scemtan/Energy_Saver_For_Hotel/README.md

# Energy_Saver_for_Hotel
Otel oda elektrik kontrol sistemi
