scemtan/Energy_Saver_For_Hotel/PCB/PCB-MAIN_ETHERNET/Hotel_Energy_Saver_Spare_List.pdf

Quantity | Stock Code | Part Description | Birim Fiyat | Toplam Fiyat
4 | CL21C220JCANNNC | MLCC (2012) 0805 22pF 100VDC ±5% C0G (NP0) | 0,0676 | 0,2704
2 | T491X686K025AT | CAP.TANTAL 68uF 25V 10% 7343 | 5,919 | 11,838
6 | CL21C101JBANNNC | MLCC (2012) 0805 100pF 50VDC ±5% C0G (NP0) | 0,07617 | 0,45702
2 | CL21C220JCANNNC | MLCC (2012) 0805 22pF 100VDC ±5% C0G (NP0) | 0,0676 | 0,1352
1 | C323C473J60A605 | CAP.POL.47nF 1600V 15MM 5% TB FARATRONIC | 2,33948 | 2,33948
2 | C323C103J60A605 | CAP.POL.10nF 1600VDC 15MM 5% MKP TB FARATRONIC | 1,0634 | 2,1268
2 | T491C106K025AT | CAP.TANTAL 10uF 25V 10% C CASE (6032) SMD | 1,57606 | 3,15212
7 | CL21B103KAANNNC | MLCC (2012) 0805 10nF 25VDC ±10% X7R | 0,06958 | 0,48706
2 | CL21B104KACNNND | MLCC (2012) 0805 100nF 25VDC ±10% X7R | 0,07926 | 0,15852
2 | T491B684K035AT | CAP.TANTAL 680uF 35V 10% B CASE (3528) | 0,92321 | 1,84642
2 | DR2R7305R | CAP.SUPER 3F 2.7V 8X20MM RADIAL THT | 5,31701 | 10,63402
11 | 0805S8F1002T5E | RES.(2012) 0805 10K Ohms 1% 1/8W-S 100PPM | 0,02095 | 0,23045
1 | 0805S8F1004T5E | RES.(2012) 0805 1M Ohms 1% 1/8W-S 100PPM | 0,02095 | 0,02095
10 | 0805S8F4700T5E | RES.(2012) 0805 470 Ohms 1% 1/8W-S 100PPM | 0,02095 | 0,2095
7 | 0805S8F1001T5E | RES.(2012) 0805 1K Ohms 1% 1/8W-S 100PPM | 0,02095 | 0,14665
1 | TC0650F3600T5G | RES.(3216) 1206 360 Ohms 1% 1/8W 50PPM | 0,13211 | 0,13211
1 | TC0650F4700T5G | RES.(3216) 1206 470 Ohms 1% 1/8W 50PPM | 0,13211 | 0,13211
1 | TC0650F390JT5G | RES.(3216) 1206 39 Ohms 1% 1/8W 50PPM | 0,13211 | 0,13211
2 | 0805S8F5600T5E | RES.(2012) 0805 560 Ohms 1% 1/8W-S 100PPM | 0,02095 | 0,0419
1 | 0805S8F2001T5E | RES.(2012) 0805 2K Ohms 1% 1/8W-S 100PPM | 0,02095 | 0,02095
1 | 0805S8F0000T5E | RES.(2012) 0805 0 Ohms 1% 1/8W-S 800PPM | 0,01264 | 0,01264
4 | 0805S8F499JT5E | RES.(2012) 0805 49.9 Ohms 1% 1/8W-S 200PPM | 0,02095 | 0,0838
1 | 0805S8F100JT5E | RES.(2012) 0805 10 Ohms 1% 1/8W-S 400PPM | 0,02095 | 0,02095
1 | 0402WGJ0222TCE | RES.(1005) 0402 2.2K Ohms 5% 1/16W 100PPM | 0,00446 | 0,00446
1 | 0402WGJ0103TCE | RES.(1005) 0402 10K Ohms 5% 1/16W 100PPM | 0,00446 | 0,00446
2 | 0402WGJ0221TCE | RES.(1005) 0402 220 Ohms 5% 1/16W 100PPM | 0,00446 | 0,00892
1 | 0402WGJ0000TCE | RES.(1005) 0402 0 Ohms 5% 1/16W 800PPM | 0,00446 | 0,00446
1 | 0805S8J0000T5E | RES.(2012) 0805 0 Ohms 5% 1/8W-S 800PPM | 0,00446 | 0,00446
1 | ATMEGA328PB-AU | IC-328PB MCU 8BIT 32KB FLASH 32TQFP | 16,94353 | 16,94353
1 | L7805CV-DG | IC-7805 V.REG.+5V 1.5A TO220 DOUBLE GAUGE ST | 1,20548 | 1,20548
1 | LM1117GS-3.3-HTC | IC-1117 3V3 LDO SOT223 SMD | 1,61341 | 1,61341
1 | MOC3021-ISO | IC-3021 DIP6 ISOCOM | 1,68372 | 1,68372
1 | BT138-600E-70127 | TRIAC DIS.12A 600V NONISOLATED SENSITIVITY TO220 | 2,74639 | 2,74639
2 | SN74LVC1G14DBVRE4 | IC-74LVC1G14 SGL SCHMT-TRIG INVERTER SOT23-5 | 0,62273 | 1,24546
1 | DI206S_R2_00001 | DIODE BRIDGE 2A 600V 1PH 4-SDIP SMT GLASS PASSIVAT | 1,77322 | 1,77322
1 | L-KLS7-TS3603B-5.0-250-T | SWITCH TACT 3.50x6.00 5.00mm 250gF SMT V/T | 0,36594 | 0,36594
1 | ENC28J60-I/SO | IC-28J60 SOIC-28 MICROCHIP | 26,76226 | 26,76226
1 | CAT24C256WI-GT3 | IC-24C256 EEPROM CMOS SMD SO8 TR ON | 2,09933 | 2,09933
4 | HL-PST-1608S9AC | LED SMD 0603 RED WATER CLEAR 50-70mcd 130C | 0,19925 | 0,797
4 | BZX84C3V3,215 | DIODE ZENER 410mW 3.3V ±5% SOT23 SMT | 0,13239 | 0,52956
4 | HL-PST-1608U51GC | LED SMD 0603 GREEN WATER CLEAR 600-800mcd 130C | 0,12025 | 0,481
4 | HL-PST-1608H203BC | LED SMD 0603 BLUE WATER CLEAR 70-100mcd 130C | 0,13109 | 0,52436
1 | MBR0520-HT | DIODE SCHOTTKY 500mA 20V SOD123 HOTTECH | 0,18078 | 0,18078
2 | M7-KT | DIODE STAND. Single 1A 1000V SMT DO214AC (SMA) | 0,06372 | 0,12744
1 | A3-5A-F | THERMAL FUSE 5A 250V 125C | 1,05808 | 1,05808
2 | MOLEX-0901310123 | PIN HEADER 6PIN(2x3) 2.54mm THT V/T | 1,52186 | 3,04372
6 | GT130-5.08-03P-14-05AH | TERM.BLK.5.08MM 3P PCB TYPE GREEN GOLTEN | 1,27608 | 7,65648
1 | HR911105A | MODULAR JACK THT R/A 8P8C (RJ45,Ethernet) GRAY | 7,38229 | 7,38229
1 | DLW21HN900SQ2L | CHOKE COMMON MODE 90R 330MA LN SMD | 0,54765 | 0,54765
1 | AS49S-16M-FC160F3 | CRYSTAL 16MHZ HC49S 16pF 20ppm SHORT BULK ANSEN | 0,85072 | 0,85072
1 | AS-25.000-18-F-H25 | CRYSTAL 25MHZ HC49ST 18PF SHORT BULK RALTRON | 1,77234 | 1,77234
1 | L-KLS1-TDC-001-2.0-T | CONNECTOR JACK DC POWER 2MM SMD | 1,33434 | 1,33434
1 | L-KLS7-MSK-12C03 | SWITCH SLIDE 1P2T SMT R/A | 1,52996 | 1,52996
1 | H11L1M | IC-11L1M OPTOISO 4.17KV OPEN COLLECTOR 6DIP | 3,63634 | 3,63634
1 | 1N4148-T4-HT | DIODE FAST SWITCHING Single 150mA 75V SMT SOD323 | 0,0543 | 0,0543
1 | | 12V 2A Adaptör | 15 | 15
1 | PCB | 1.65$ | 12,25 | 12,25
1 | ATTINY85-20SUR | ATTINY85-20SUR | 14,62265 | 14,62265
| 0
| 0
Toplam | 164,47367
KDV | 18%
Genel Toplam | 194,0789306
