scemtan/Energy_Saver_For_Hotel/PCB/PCB-MAIN_ETHERNET/Hotel_Energy_Saver_Bottom.pdf

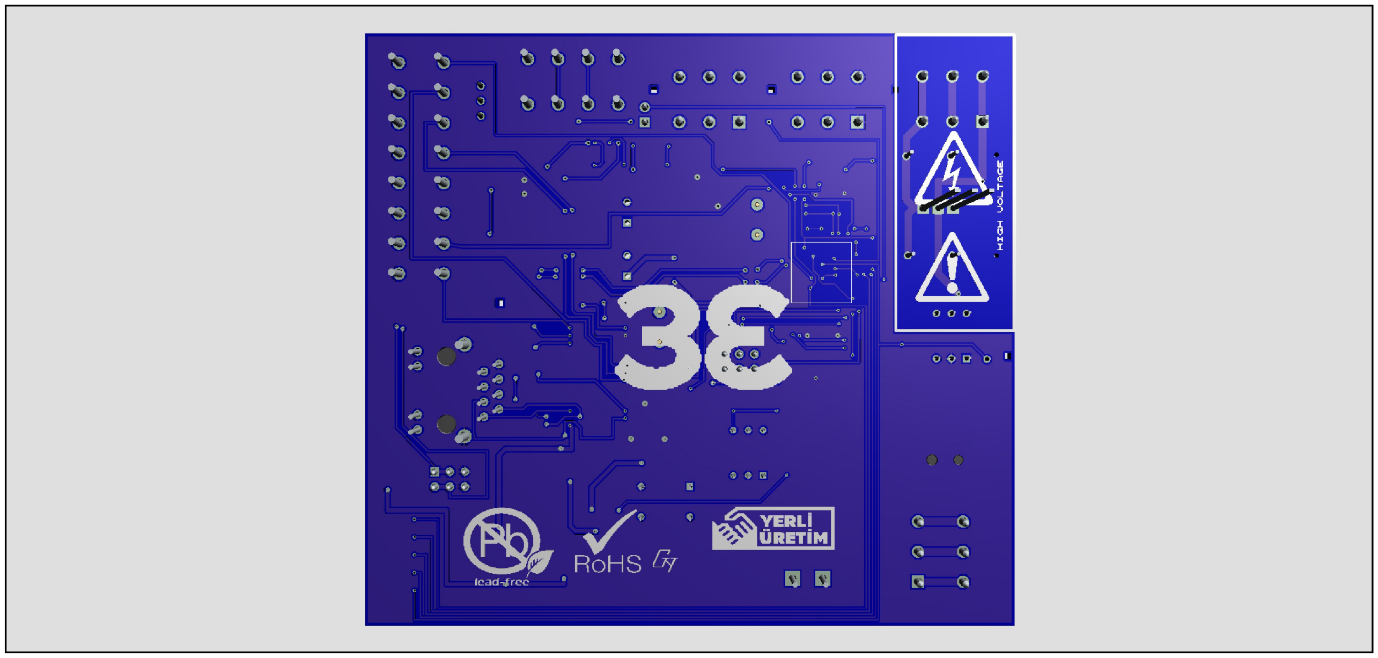
[picture p3: figure]
