scemtan/Energy_Saver_For_Hotel/PCB-MAIN_ETHERNET_BOM_LIST.pdf

sıra | parça no | stok kod | ürün açıklaması | adet
1 | C1-C2,C14-C15 | CL21C220JCANNNC | MLCC (2012) 0805 22pF 100VDC ±5% C0G (NP0) | 4
2 | C3-C4 | T491X686K025AT | CAP.TANTAL 68uF 25V 10% 7343 | 2
3 | C5-C10 | CL21C101JBANNNC | MLCC (2012) 0805 100pF 50VDC ±5% C0G (NP0) | 6
4 | C12 | C323C473J60A605 | CAP.POL.47nF 1600V 15MM 5% TB FARATRONIC | 1
5 | C13 | C323C103J60A605 | CAP.POL.10nF 1600VDC 15MM 5% MKP TB FARATRONIC | 1
6 | C16,C22 | T491C106K025AT | CAP.TANTAL 10uF 25V 10% C CASE (6032) SMD | 2
7 | C17-C21,C23-C24 | CL21B103KCANNNC | MLCC (2012) 0805 10nF 100VDC ±10% X7R | 4
8 | C26,C29,C11,C25 | CL21B104KBCNNND | MLCC (2012) 0805 100nF 50VDC ±10% X7R | 4
9 | C27-C28 | T491B684K035AT | CAP.TANTAL 680uF 35V 10% B CASE (3528) | 2
10 | C30-C31 | DR2R7305R | CAP.SUPER 3F 2.7V 8X20MM RADIAL THT | 2
11 | R1-R4,R12,R17-R18,R36-R37,R40 | 0805S8F1002T5E | RES.(2012) 0805 10K Ohms 1% 1/8W-S 100PPM | 10
12 | R5 | 0805S8J0105T5E | RES.(2012) 0805 1M Ohms 5% 1/8W-S 100PPM | 1
13 | R6,R13-R14,R29-R35,R48 | 0805S8J0471T5E | RES.(2012) 0805 470 Ohms 5% 1/8W-S 100PPM | 11
14 | R7-R8,R15-R16,R27-R28,R38 | 0805S8F1001T5E | RES.(2012) 0805 1K Ohms 1% 1/8W-S 100PPM | 7
15 | R9 | 1206S4F3600T5E | RES.(3216) 1206 360 Ohms 1% 1/4W-S 100PPM | 1
16 | R10 | 1206S4J0471T5E | RES.(3216) 1206 470 Ohms 5% 1/4W-S 100PPM | 1
17 | R11 | 1206S4J0390T5E | RES.(3216) 1206 39 Ohms 5% 1/4W-S 200PPM | 1
18 | R19-R20 | 0805S8F5600T5E | RES.(2012) 0805 560 Ohms 1% 1/8W-S 100PPM | 2
19 | R21 | 0805S8F2001T5E | RES.(2012) 0805 2K Ohms 1% 1/8W-S 100PPM | 1
20 | R22,R41-R42 | 0805S8J0000T5E | RES.(2012) 0805 0 Ohms 5% 1/8W-S 800PPM | 3
21 | R23-R26 | 0805S8F499JT5E | RES.(2012) 0805 49.9 Ohms 1% 1/8W-S 200PPM | 4
22 | R39 | 0805S8F100JT5E | RES.(2012) 0805 10 Ohms 1% 1/8W-S 400PPM | 1
23 | R45 | 0402WGJ0222TCE | RES.(1005) 0402 2.2K Ohms 5% 1/16W 100PPM | 1
24 | R47-R49 | 0402WGJ0103TCE | RES.(1005) 0402 10K Ohms 5% 1/16W 100PPM | 2
25 | R46 | 0402WGJ0221TCE | RES.(1005) 0402 220 Ohms 5% 1/16W 100PPM | 1
26 | R43-R44-SDA-SCL | 0402WGJ0000TCE | RES.(1005) 0402 0 Ohms 5% 1/16W 800PPM | 4
27 | U1 | ATMEGA328P-AU | IC-328 MCU 8BIT 32KB FLASH 32TQPF ATMEL | 1
28 | U2 | L7805CV-DG | IC-7805 V.REG.+5V 1.5A TO220 DOUBLE GAUGE ST | 1
29 | U3 | LM1117GS-3.3-HTC | IC-1117 3V3 LDO SOT223 SMD | 1
30 | U4 | MOC3021M-FSC | IC-3021 OPTOISOLATOR 4.17KV TRIAC 6DIP | 1
31 | U5 | BT138-600E-70127 | TRIAC DIS.12A 600V NONISOLATED SENSITIVITY TO220 | 1
32 | U6-U7 | SN74LVC1G14DBVR | IC-74LVC14 BUFFER SCHMIT TRIG SOT23-5 SMD | 2
33 | U8 | DI206S_R2_00001 | DIODE BRIDGE 2A 600V 1PH 4-SDIP SMT GLASS PASSIVAT | 1
34 | U12-U13 | L-KLS7-TS3603B-5.0-250-T | SWITCH TACT 3.50x6.00 5.00mm 250gF SMT V/T | 1
35 | U10 | ENC28J60-I/SO | IC-28J60 SOIC-28 MICROCHIP | 1
36 | U11 | CAT24C256WI-GT3 | IC-24C256 EEPROM CMOS SMD SO8 TR ON | 1
37 | U14 | H11L1M | IC-11L1M OPTOISO 4.17KV OPEN COLLECTOR 6DIP | 1
38 | U9 | L-KLS7-MSK-12C03 | SWITCH SLIDE 1P2T SMT R/A | 1
39 | X1 | AS49S-16M-FC160F3 | CRYSTAL 16MHZ HC49S 16pF 20ppm SHORT BULK ANSEN | 1
40 | X2 | AS-25.000-18-F-H25 | CRYSTAL 25MHZ HC49ST 18PF SHORT BULK RALTRON | 1
41 | D1-D2-D8-D13 | HL-PST-1608S9AC | LED SMD 0603 RED WATER CLEAR 50-70mcd 130C | 4
42 | D3-D4,D16-D17 | BZX84C3V3,215 | DIODE ZENER 410mW 3.3V ±5% SOT23 SMT | 4
43 | D5,D9,D12 | HL-PST-1608U51GC | LED SMD 0603 GREEN WATER CLEAR 600-800mcd 130C | 3
44 | D6,D10-D11,D19 | HL-PST-1608H203BC | LED SMD 0603 BLUE WATER CLEAR 70-100mcd 130C | 3
45 | D7 | MBR0520-HT | DIODE SCHOTTKY 500mA 20V SOD123 HOTTECH | 1
46 | D14-D15 | M7-KT | DIODE STAND. Single 1A 1000V SMT DO214AC (SMA) | 2
47 | D18 | 1N4148WS-HT | DIODE FAST SWITCHING Single 150mA 75V SMT SOD323 | 1
48 | F1 | A3-5A-F | THERMAL FUSE 5A 250V 125C | 1
49 | J1-J2 | MOLEX-0901310123 | PIN HEADER 6PIN(2x3) 2.54mm THT V/T | 2
50 | J3-J4,J6-J7 | DG142V-5.08-03P-14-00AH | TERM.BLK.5.08MM 3P PCB SPRING TYPE | 4
51 | J5 | HR911105A | MODULAR JACK THT R/A 8P8C (RJ45,Ethernet) GRAY | 1
52 | J8 | DG142V-5.08-04P-14-00AH | TERM.BLK.5.08MM 4P PCB SPRING TYPE | 1
53 | J9 | DG127S-5.08-08P-14-00AH | TERM.BLK.5.08MM 8P PCB TYPE 0 BOY GREEN GAOSONG | 1
54 | J10 | L-KLS1-207A-1-02-TC-R | PIN HEADER 2PIN(1x2) 2.54mm SMT R/A | 1
55 | J14 | L-KLS1-TDC-001-2.0-T | CONNECTOR JACK DC POWER 2MM SMD | 1
56 | L1 | 10mH | | 1
57 | Q1 | BC817-40,215 | TRANSISTOR DIS.500mA 45V NPN SOT23 GEN. SMT | 1
