scemtan/Energy_Saver_For_Hotel/PCB/PCB-MAIN_FOR_THE_GRANADA/hotel_energy_saver_for_the_granada - CADCAM.PDF

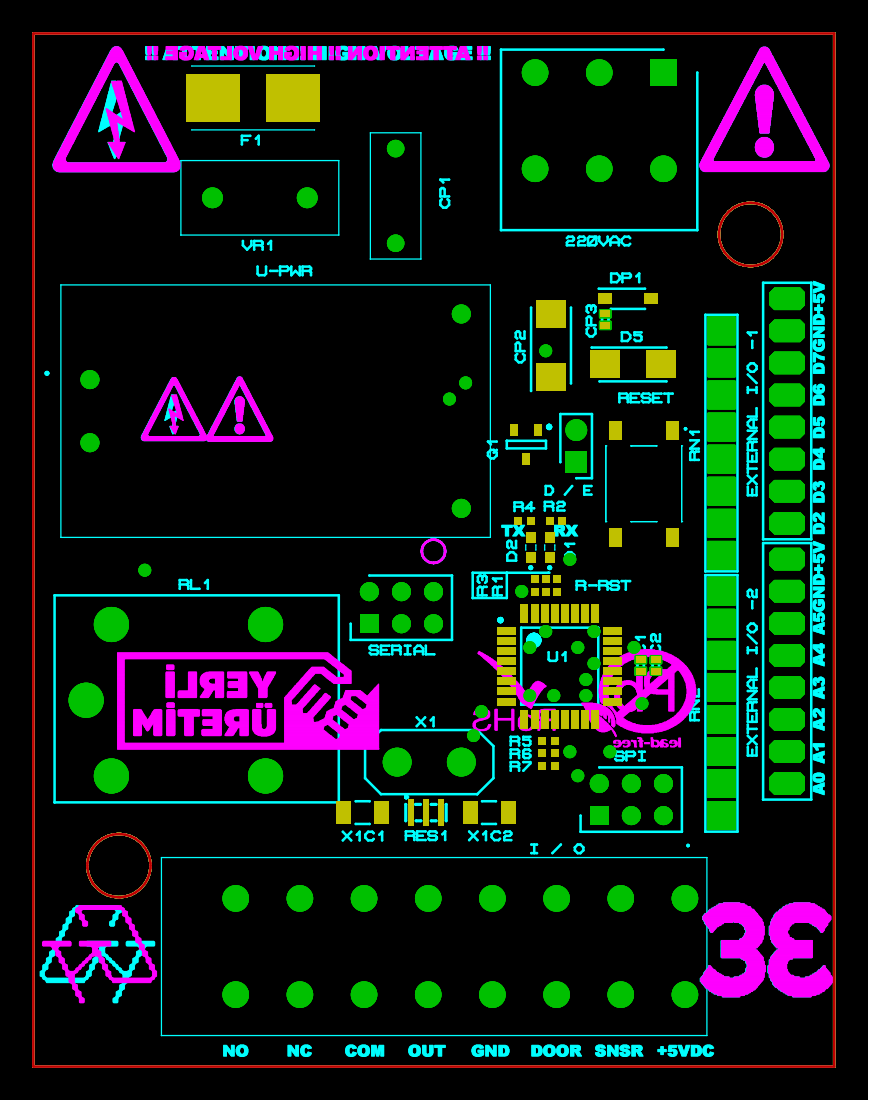
[picture p5: page 1]
