scemtan/Energy_Saver_For_Hotel/PCB/PCB-MAIN_ETHERNET/hotel_energy_saver - CADCAM.PDF

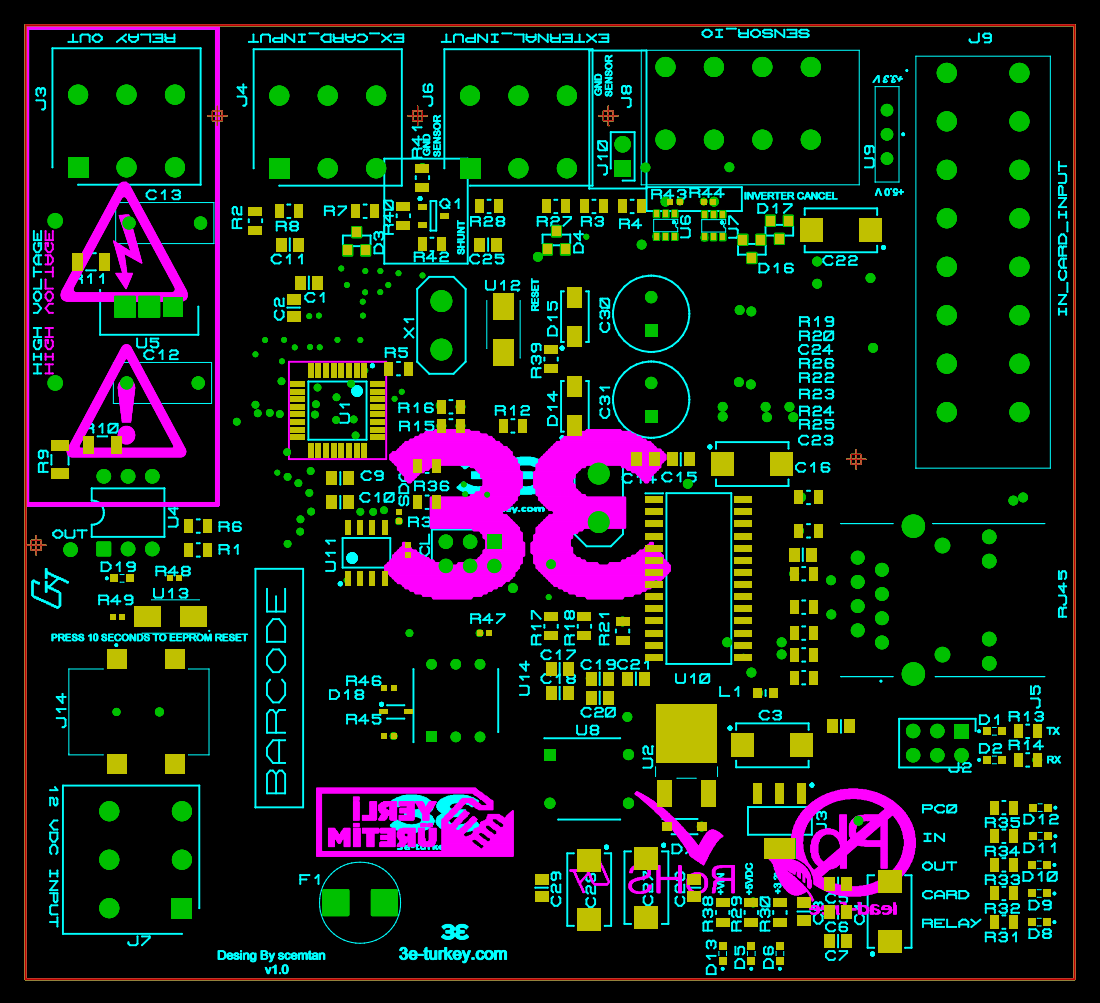
[picture p7: page 1]
