scemtan/Energy_Saver_For_Hotel/PCB/PCB-MAIN_ETHERNET/Hotel_Energy_Saver.pdf

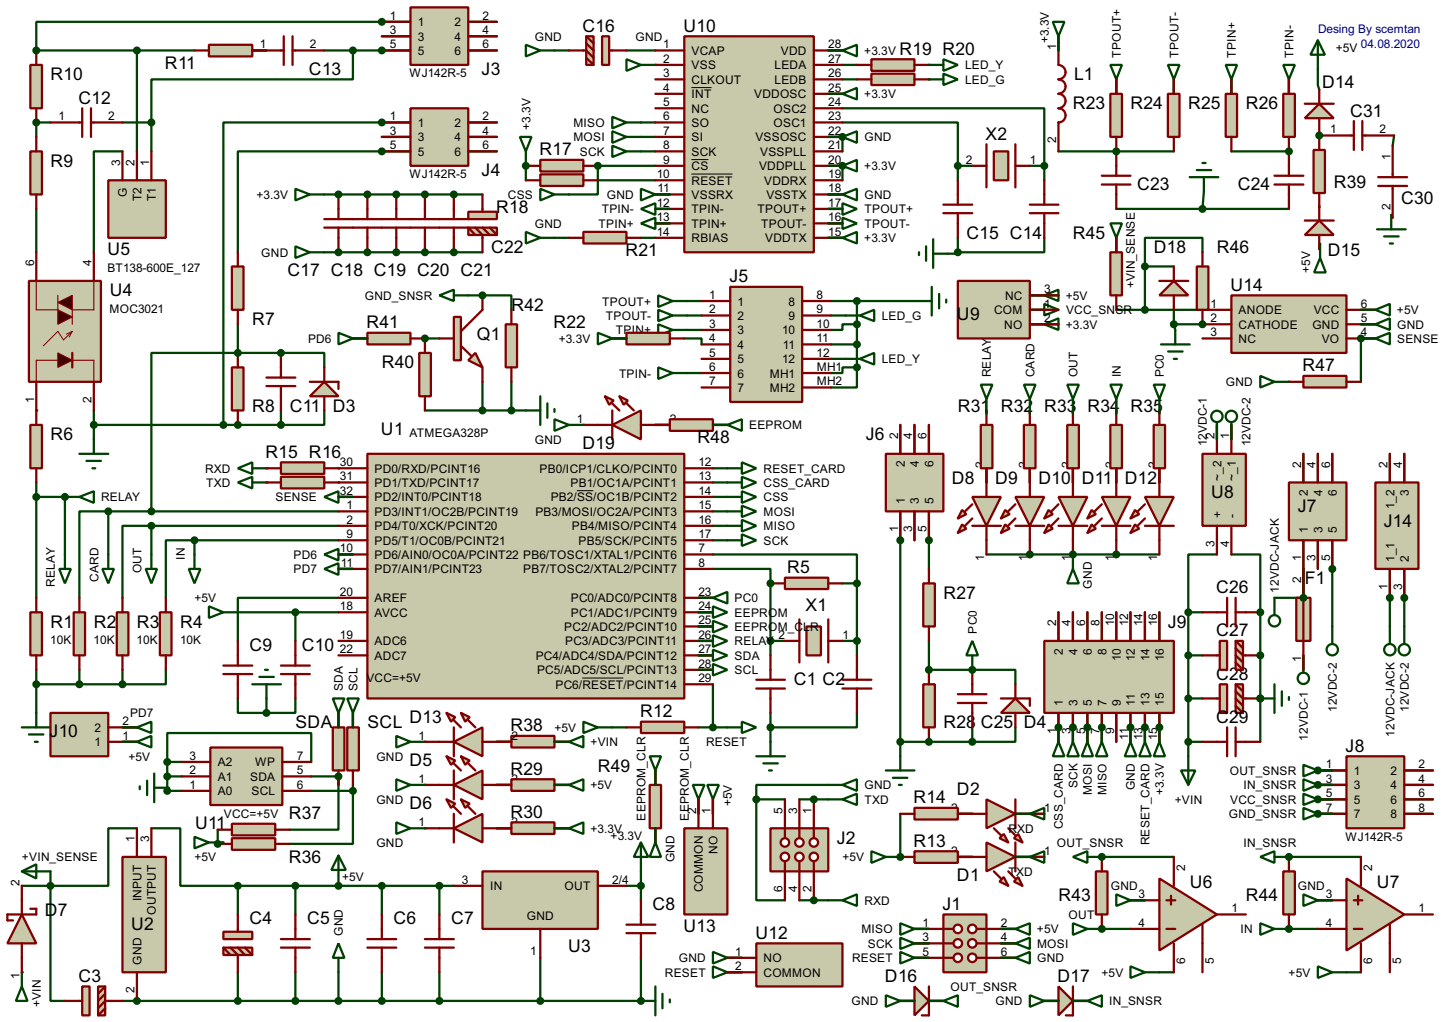
[picture p8: page 1]
