scemtan/Energy_Saver_For_Hotel/(list of files, drawings)

Other design files:
PCB/PCB-MAIN_ETHERNET/hotel_energy_saver.pdsprj
PCB/PCB-MAIN_FOR_THE_GRANADA/hotel_energy_saver_for_the_granada.pdsprj
PCB/PCB-US_SENSOR/Bottom 25X15/ULTRASONIC_SENSOR_DEVRESI.pdsprj
PCB/PCB-US_SENSOR/Top 25X12.5/ULTRASONIC_SENSOR_DEVRESI.pdsprj
