scemtan/Energy_Saver_For_Hotel/Software/otel_enerji_koruma_distan_kartli_sisteme_entegre/otel_enerji_koruma_distan_kartli_sisteme_entegre.ino

#include <avr/wdt.h>
#include <Wire.h>
#include <EEPROM.h>
String s = "0";
unsigned long int xyz = 0;
int address = 143, read_value = 0, eeprom = A1, eeprom_clr = A2, relay = A3, sense = 2,
    EXTERNAL_RFID = 3, OUT = 4, IN = 5, GND = 6, pir_header = 7, count = 0, statePIN = LOW, previous = LOW, say = 0,
    statu, statu_in, statu_out, statu_pir, statu_eeprom, x;
int sclPin = A5, sdaPin = A4;
int gnd_sensor_time = 50; // 1 = 1 msn // açma kapama süresi
int zaman = 300; // 10 = 1 sn // person "0" olunca relay kapanma süresi
int dividing = 10; // zaman'ı bölen sayısı
int t = 500; // iki sensörden geçiş süresi
int t_setup = 2500; // setup bölümünde tanıtım yazı süresi
long time = 0;
long debounce = 200;
boolean state = true;
bool islem = false;
/* Software Communication List ==>
   reset & restart
   eeprom
   clear
   electric
   open
   close
   ++
   --
   sensor
   end
*/
void setup() {
  Serial.begin(115200);
  pinMode(IN, INPUT);
  pinMode(OUT, INPUT);
  pinMode(pir_header, INPUT);
  pinMode(eeprom_clr, INPUT);
  pinMode(eeprom, OUTPUT);
  pinMode(GND, OUTPUT);
  pinMode(relay, OUTPUT);
  digitalWrite(GND, HIGH);
  attachInterrupt(0, electric_sense, RISING);
  Wire.begin();
  Serial.println("3e-turkey.com");
  delay (t_setup);
  Serial.println("OTEL ENERGY SAVER");
  delay (t_setup);
  {
    read_value = EEPROM.read(143);
    if (read_value == 255) {
      count = 0;
    }
    else
    {
      count = read_value;
    }
    Serial.println(count);
  }
}
void toogle_led50() {
  digitalWrite(eeprom, !digitalRead(eeprom));
  delay(50);
}
void electric_sense() {
  Serial.println("ELEKTRİK KESİNTİSİ"); // EEPROM Register
  Serial.println(count);
  EEPROM.write(address, (count & 0xFF));
}
void electric_off(){
  if (digitalRead(sense) == HIGH){
  Serial.println("⚡⚡ ELEKTRIK ⚡⚡ ⚡⚡ KESINTISI 'I2C' ⚡⚡"); //⚡⚡⚡⚡⚡⚡⚡
  }
}
void (*softwareReset)( void ) = 0x0000; // Atmega328P için 0x0000
void software_communication() {
  if (Serial.available() > 0) {
    s = Serial.readString();
  }
  if ((s.indexOf("reset") >= 0) || (s.indexOf("restart") >= 0))  //  if ((s.indexOf("reset") >= 0)
  {
    role_off();
    Serial.println("Software Reset");
    delay(250);
    softwareReset();
  }
  if ((s.indexOf("eeprom") >= 0))
  {
    s = "end";
    read_value = EEPROM.read(143);
    count = read_value;
    Serial.println(count);
  }
  if ((s.indexOf("clear") >= 0))
  {
    Serial.println("EEPROM Clear");
    delay(100);
    eeprom_clear();
    Serial.println("Restart");
    softwareReset();
  }
  if ((s.indexOf("electric") >= 0))
  {
    Serial.println("Electric Data EEPROM Write Test");
    EEPROM.write(address, (142 & 0xFF));
    role_off();
    Serial.println("Restart");
    delay(250);
    softwareReset();
  }
  if ((s.indexOf("open") >= 0))  //  if ((s.indexOf("reset") >= 0) || (s.indexOf("5555") >= 0))
  {
    count = 9999;
    role_on();
  }
  if ((s.indexOf("close") >= 0))  //  if ((s.indexOf("reset") >= 0) || (s.indexOf("5555") >= 0))
  {
    count = 0;
    role_off();
    s = "end";
  }
  if ((s.indexOf("++") >= 0))  //  if ((s.indexOf("reset") >= 0) || (s.indexOf("5555") >= 0))
  {
    count++;
    role_on();
    Serial.println(count);
  }
  if ((s.indexOf("--") >= 0))  //  if ((s.indexOf("reset") >= 0) || (s.indexOf("5555") >= 0))
  {
    count--;
    if (count == 0)
    {
      count = 0;
      role_off();
      s = "end";
      Serial.println("0");
    }
    else if (count <= -1)
    {
      count = 0;
    }
    else
    {
      Serial.println(count);
    }
  }
  if ((s.indexOf("sensor") >= 0))  //  if ((s.indexOf("reset") >= 0) || (s.indexOf("5555") >= 0))
  {
    if (digitalRead(IN) == HIGH) {
      count = -9999;
      Serial.println("IN Sensor");
    }
    if (digitalRead(OUT) == HIGH) {
      count = -9999;
      Serial.println("OUT Sensor");
    }
  }
  if ((s.indexOf("end") >= 0))
  {
  }
}
void eeprom_clear() {
  for (int i = 0 ; i < EEPROM.length() ; i++) {
    EEPROM.write(i, 0);
  }
  EEPROM.end();
}
void eeprom_reset_and_restart() {
  if (digitalRead(eeprom_clr) == HIGH)
  {
    digitalWrite(eeprom, HIGH);
    Serial.println(F("Hafıza silme işlemi için butona 10 sn. basılı tutunuz. Aksi takdirde Hafıza silinmeyecektir."));
    delay(10000);
    if (digitalRead(eeprom_clr) == HIGH)
    {
      Serial.println(F("Hafızadaki tüm kayıtlar silinecek ve bu işlem geri alınamayacak."));
      Serial.println(F("Hafıza silme işlemine başlanıyor."));
      for (int i = 0 ; i < 250 ; i++) {
        toogle_led50();
      }
      eeprom_clear();
      Serial.println(F("Hafıza silme işlemi başarıyla tamamlandı.."));      
      digitalWrite(eeprom, HIGH);
      delay(250);
      digitalWrite(eeprom, LOW);
      delay(250);
      digitalWrite(eeprom, HIGH);
      delay(250);
      digitalWrite(eeprom, LOW);
      delay(250);
      digitalWrite(eeprom, HIGH);
      delay(250);
      digitalWrite(eeprom, LOW);
      delay(250);
      digitalWrite(eeprom, HIGH);
      delay(250);
      digitalWrite(eeprom, LOW);
      delay(250);
      digitalWrite(eeprom, HIGH);
      delay(250);
      digitalWrite(eeprom, LOW);
      read_value = EEPROM.read(143);
      count = read_value;
      Serial.println(count);
      role_off();
      softwareReset();
    }
    else
    {
      Serial.println(F("Hafıza silme işlemi iptal edildi."));
      digitalWrite(eeprom, LOW);
    }
  }
}
void eeprom_read(){
  if (read_value >= 1 && count >=1)
{
      statePIN = HIGH;
      role_on();
}
}    
void role_on() {
  digitalWrite(relay, HIGH);
  delay(25);
}
void role_off() {
  digitalWrite(relay, LOW);
  delay(25);
}
void sensor_gnd_on_off() {
  statu_pir = digitalRead(pir_header);
  if (statu_pir == HIGH) {
    statu_in = digitalRead(IN);
    if (statu_in == HIGH) {
      digitalWrite(GND, LOW);
      delay(gnd_sensor_time);
      digitalWrite(GND, HIGH);
    }
    else {
    }
    statu_out = digitalRead(OUT);
    if (statu_out == HIGH) {
      digitalWrite(GND, LOW);
      delay(gnd_sensor_time);
      digitalWrite(GND, HIGH);
    }
    else {
    }
  }
  else {
    digitalWrite(GND, HIGH);
  }
}
void external_card() {
  if (digitalRead(EXTERNAL_RFID) == HIGH && millis() - time > debounce) {
    Serial.println("Card Entry");
    if (statePIN == HIGH)
      statePIN ;
    else
      statePIN = HIGH;
    time = millis();
  }
  else if (statePIN == LOW)
    statePIN = LOW;
  else if (statePIN = HIGH)
    io();
  previous = statu;
}
void io() {
  {
    if (digitalRead(IN) == HIGH) {
      while (digitalRead(IN) == HIGH)delay(t); count++;
      //sensor_gnd_on_off();
      if (count > 0) {
        Serial.println(count);
        role_on();
      }
    }
  }
  {
    if (digitalRead(OUT) == HIGH) {
      while (digitalRead(OUT) == HIGH)delay(t); count--;
      //sensor_gnd_on_off();
      //Serial.println(count);
      if (count == 0) {
        for (int sure = 0; sure < zaman ; sure++)
        {
          delay(100);
          Serial.print("TIME     : ");
          Serial.print (zaman / dividing);
          Serial.print ("/");
          Serial.println ((sure / dividing) + 1);
          if (digitalRead(IN) == HIGH) {
            if (digitalRead(IN) == HIGH) {
              return;
            }
          }
        }
        count = 0;
        role_off();
        statePIN = LOW;
        Serial.println("0");
      }
      else if (count < 0) {
        count = 0;
        role_off();
        //statePIN = LOW;
      }
      else
      {
        Serial.println(count);
      }
    }
  }
}
void loop () {  
  software_communication();
  eeprom_read();
  external_card();
  eeprom_reset_and_restart();
  electric_off();
}
