scemtan/Energy_Saver_For_Hotel/(commit log)

2020-12-04 3e-turkey Project
    proteus için yeniden yükleme
    [ULTRASONIC_SENSOR_DEVRESI.pdsprj]
2021-01-03 3e-turkey Project
    * PCB Desing Add
    * Revision
    [IR_ALICI_VERICI_DEVRESI (BD139).pdsprj, IR_ALICI_VERICI_DEVRESI.pdsprj, ULTRASONIC_SENSOR_DEVRESI.pdsprj, hotel_energy_saver.pdsprj, ne555 frekans hesaplama.xlsx]
2021-01-21 3e-turkey Project
    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
    [otele energy saver parça listesi.xlsx]
2021-02-11 3e-turkkey Project
    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
    [IR_ALICI_VERICI_DEVRESI (BD139).pdsprj, IR_ALICI_VERICI_DEVRESI.pdsprj, ULTRASONIC_SENSOR_DEVRESI.pdsprj, hotel_energy_saver.pdsprj, ne555 frekans hesaplama.xlsx]
